ThingsLog/lora-wmesh/hardware/carrier-z128/placement-preview.png

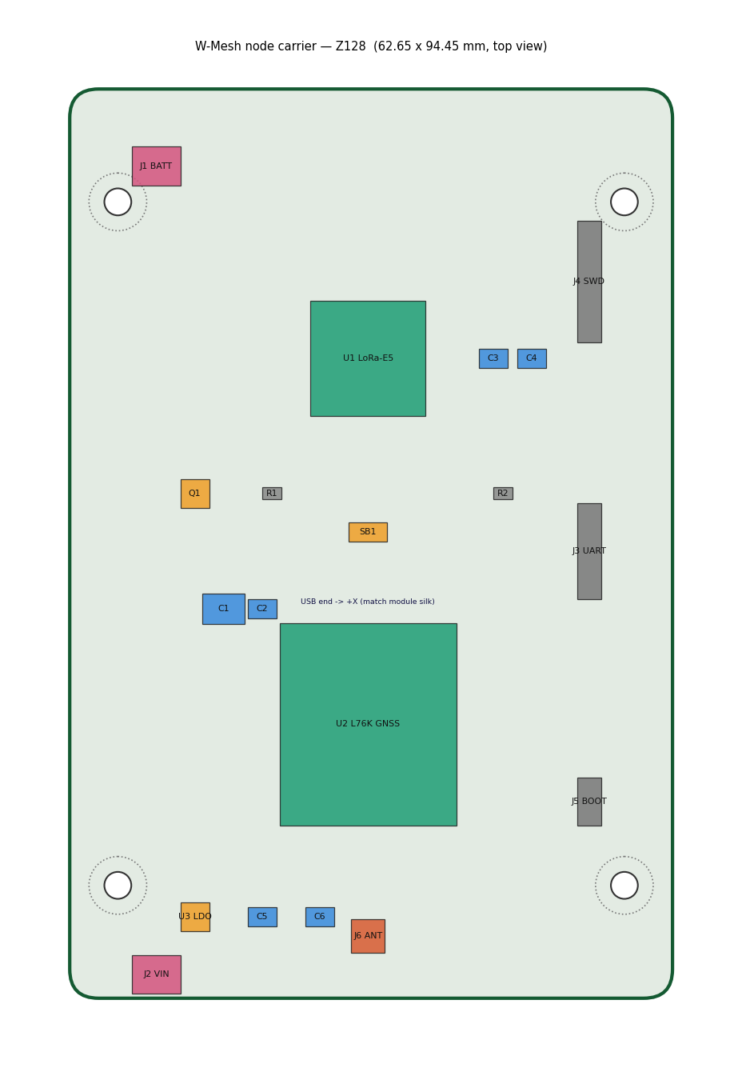
hardware/carrier-z128/placement-preview.png
