ThingsLog/lora-wmesh/hardware/carrier-z128/render-top.png

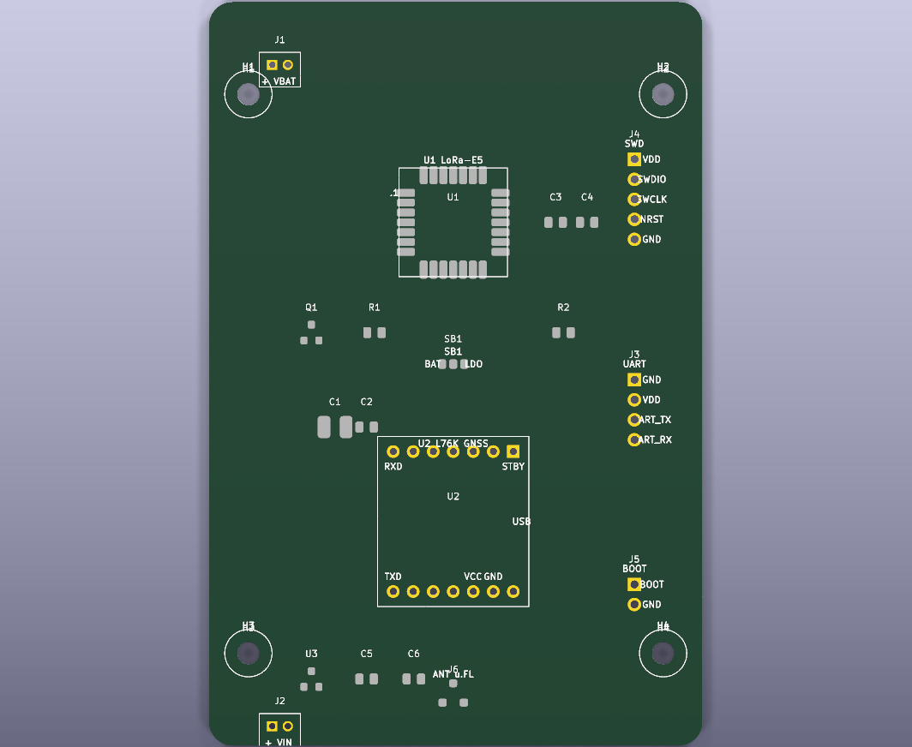
hardware/carrier-z128/render-top.png
