ThingsLog/lora-wmesh/hardware/carrier-z128/BOM.csv

Ref | Qty | Value | Part | Footprint | LCSC (verify) | Assembly | Notes
U1 | 1 | LoRa-E5-HF | Seeed LoRa-E5-HF (STM32WLE5JC) | LoRa-E5 (SMD-28 12x12mm) | C5334317 | Hand-solder | Main MCU+radio module. -HF = 868/915 MHz. Pads 1..28 per Seeed datasheet.
U2 | 1 | L76K GNSS for XIAO | Seeed 109100021 | XIAO-Add-On (2x7 THT 2.54mm) | - | Hand-solder | Quectel L76K GNSS, XIAO form. Buy from Seeed/comet.bg. Own u.FL + active antenna + RTC backup onboard.
Q1 | 1 | IRLML6402 | P-MOSFET -20V logic-level | SOT-23 | C122050 | SMT | GPS VCC high-side gate. Alt JLC-basic: AO3401A (C15127). Gate<-PB4.
U3 | 1 | MCP1700-3302 | LDO 3.3V low-Iq (~1.6uA) | SOT-23 (1=VIN 2=GND 3=VOUT) | C39290 | SMT | OPTIONAL bench/USB path. Only populated if powering from VIN (18650/USB). Alt HT7333 (SOT-89, different pinout).
R1 | 1 | 100k | Gate pull-up | R0805 | C17633 | SMT | PB4 gate pull-up to VDD -> GPS OFF by default.
R2 | 1 | 100k | BOOT pull-up | R0805 | C17633 | SMT | PB13 pull-up to VDD (boot = normal).
C1 | 1 | 100uF | Bulk decoupling (GPS) | C1210 (MLCC 6.3V+) | C159575 | SMT | At GPS 3V3/GND. Fixes acquisition-spike brownout.
C2 | 1 | 100nF | HF decoupling (GPS) | C0805 | C49678 | SMT | At GPS 3V3/GND.
C3 | 1 | 10uF | Bulk decoupling (MCU) | C0805 (MLCC 10V+) | C15525 | SMT | At U1 VCC.
C4 | 1 | 100nF | HF decoupling (MCU) | C0805 | C49678 | SMT | At U1 VCC.
C5 | 1 | 1uF | LDO input cap | C0805 | C28323 | SMT | At U3 VIN. Only if U3 populated.
C6 | 1 | 1uF | LDO output cap | C0805 | C28323 | SMT | At U3 VOUT. Only if U3 populated.
J1 | 1 | BATT | 2-pin JST-PH 2.0 (or screw term) | JST_PH_S2B | C173752 | SMT | VBAT+ / GND. FIELD: 3.6V LiSOCl2 (EVE ER26500 C) + EVE HLC1520 in parallel, off-board wires.
J2 | 1 | VIN | 2-pin JST-PH 2.0 | JST_PH_S2B | C173752 | SMT | OPTIONAL bench input 4.5-6V (18650 or USB 5V) -> U3 LDO. Do NOT use J1 for 18650.
J3 | 1 | UART | 1x4 header 2.54mm | PinHeader_1x04 | C2897 | Hand-solder | GND / 3V3 / TX(PB6) / RX(PB7) console for FTDI/CP2102 cable.
J4 | 1 | SWD | 1x5 header 2.54mm | PinHeader_1x05 | C2897 | Hand-solder | 3V3 / SWDIO(PA13) / SWCLK(PA14) / NRST / GND for ST-Link.
J5 | 1 | BOOT | 1x2 header 2.54mm + jumper | PinHeader_1x02 | C2897 | Hand-solder | PB13 / GND. Short = enter ROM bootloader.
J6 | 1 | ANT | u.FL / IPEX SMD | uFL_SMD | C881321 | SMT | LoRa antenna, from U1 RFIO (pad15). GPS antenna is on U2.
SB1 | 1 | SRC SEL | Solder jumper 3-way | SolderJumper_3way | - | - | Source select: VBAT-direct (LiSOCl2) [default] OR LDO-out (VIN). NEVER both.
H1 | 1 | Mount | Mounting hole Ø2.8 | MountingHole_2.8 | - | - | Z128 Ø2.5 self-tap post. VERIFY vs box.
H2 | 1 | Mount | Mounting hole Ø2.8 | MountingHole_2.8 | - | - | Z128 Ø2.5 self-tap post. VERIFY vs box.
H3 | 1 | Mount | Mounting hole Ø2.8 | MountingHole_2.8 | - | - | Z128 Ø2.5 self-tap post. VERIFY vs box.
H4 | 1 | Mount | Mounting hole Ø2.8 | MountingHole_2.8 | - | - | Z128 Ø2.5 self-tap post. VERIFY vs box.
