ThingsLog/lora-wmesh/hardware/carrier-z128/wmesh-node-z128.kicad_pcb

## KiCad design hardware/carrier-z128/wmesh-node-z128.kicad_pcb (2026-10-29)

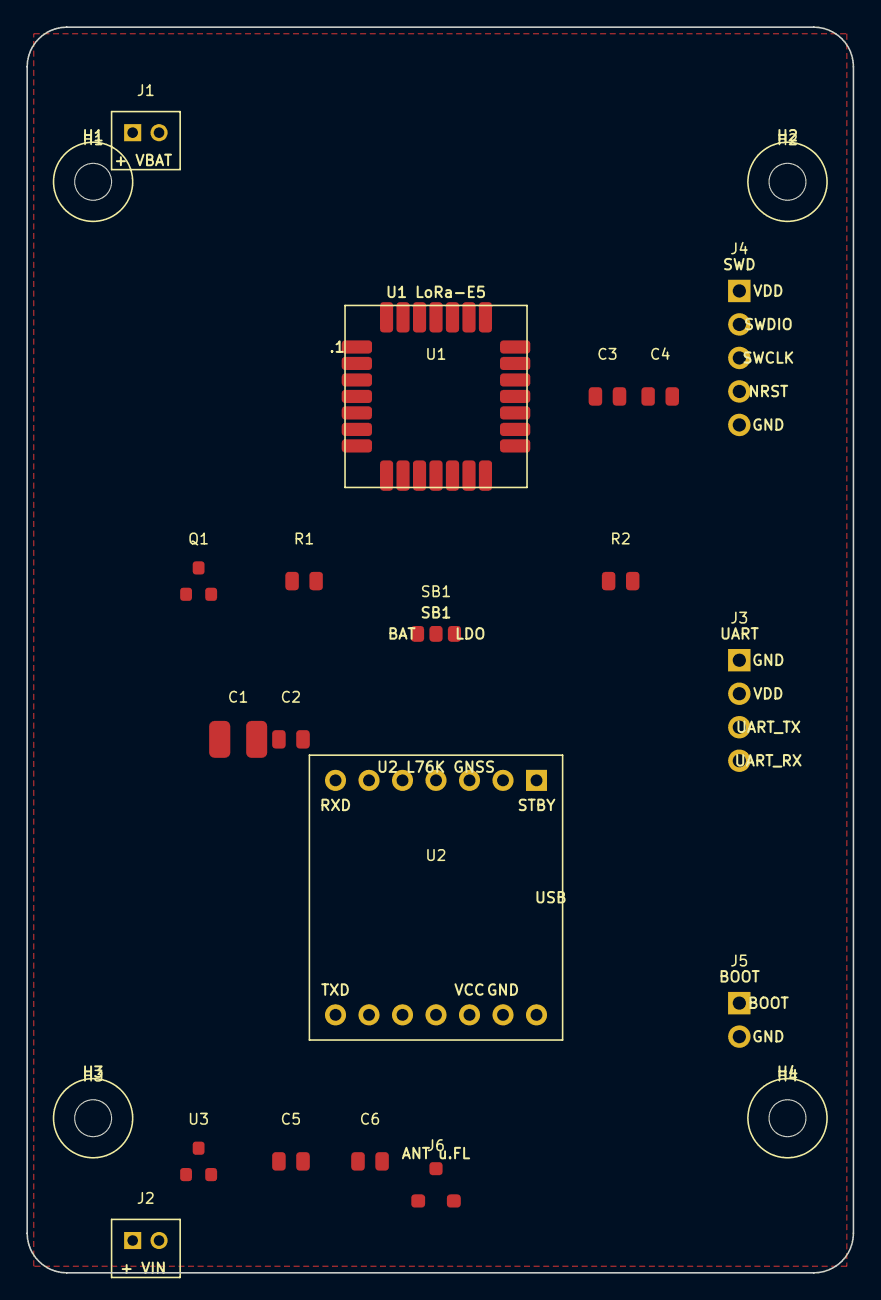
[picture p7: board wmesh-node-z128.kicad_pcb from above]

Board: 2 copper layers, 62.6 x 94.5 mm, 23 parts (0 on the bottom side), 16 nets, no tracks yet.

Parts:
C1: 100uF; C_1210
C2, C4: 100nF; C_0805
C3: 10uF; C_0805
C5, C6: 1uF; C_0805
H1, H2, H3, H4: Mnt; MountingHole_2.8
J1: BATT; JST_PH_2
J2: VIN; JST_PH_2
J3: UART; PinHeader_1x4
J4: SWD; PinHeader_1x5
J5: BOOT; PinHeader_1x2
J6: u.FL; uFL_SMD
Q1: IRLML6402; SOT-23
R1, R2: 100k; C_0805
SB1: SRC; SolderJumper_3
U1: LoRa-E5-HF; LoRa-E5
U2: L76K-GNSS-XIAO; L76K_XIAO
U3: MCP1700-3302; SOT-23

Connections:
BOOT: J5.1, R2.1, U1.24
GND: C1.2, C2.2, C3.2, C4.2, C5.2, C6.2, J1.2, J2.2, J3.1, J4.5, J5.2, J6.2, J6.3, U1.2, U1.14, U1.16, U1.22, U2.9, U3.2
GPS_VCC: C1.1, C2.1, Q1.3, U2.1, U2.10
LPUART_RX: U1.13, U2.14
LPUART_TX: U1.12, U2.7
NRST: J4.4, U1.17
PB4_GATE: Q1.1, R1.1, U1.7
RF: J6.1, U1.15
SWCLK: J4.3, U1.4
SWDIO: J4.2, U1.3
UART_RX: J3.4, U1.9
UART_TX: J3.3, U1.10
VBAT: J1.1, SB1.1
VDD: C3.1, C4.1, J3.2, J4.1, Q1.2, R1.2, R2.2, SB1.2, U1.1
VDD_LDO: C6.1, SB1.3, U3.3
VIN: C5.1, J2.1, U3.1
